Benny-Gil/the-101-router-skadis-mount/docs/images/bracket-dark.png

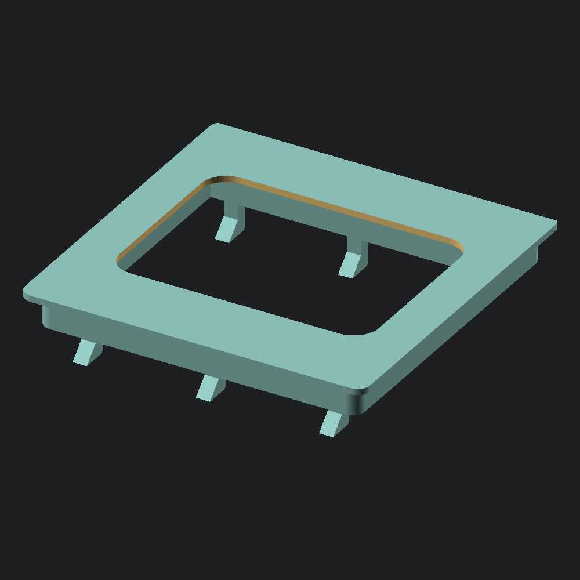
docs/images/bracket-dark.png
