Benny-Gil/the-101-router-skadis-mount/docs/images/hooks-dark.png

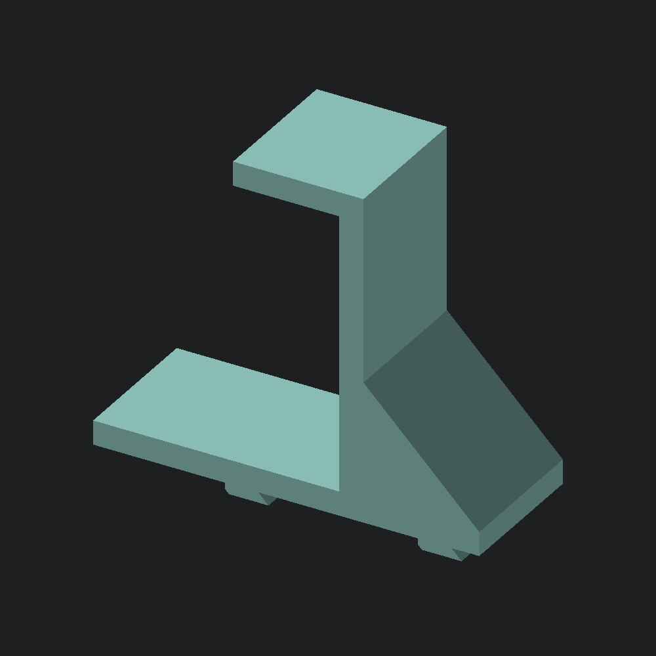
docs/images/hooks-dark.png
