Benny-Gil/the-101-router-skadis-mount/stl/101_skadis_bracket_3mm.stl

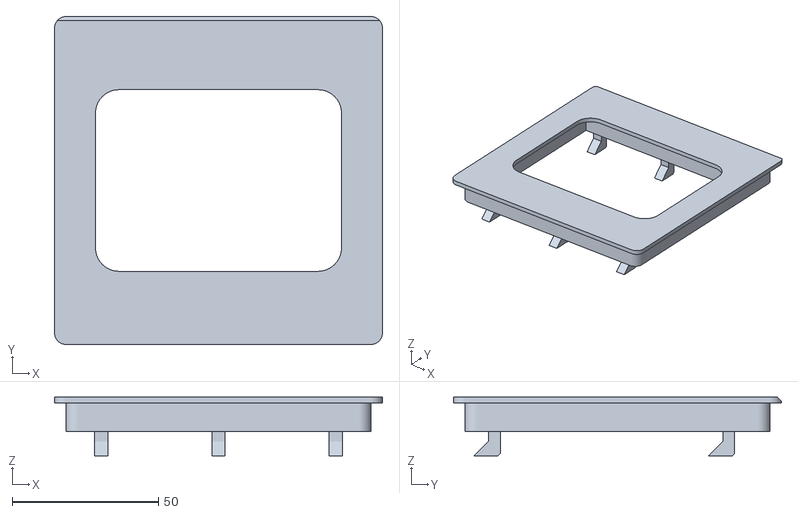
[picture p5: CAD file, 2026-10-25]
stl/101_skadis_bracket_3mm.stl
112.0 x 112.0 x 20.1
