Benny-Gil/the-101-router-skadis-mount/stl/101_skadis_hooks_3mm.stl

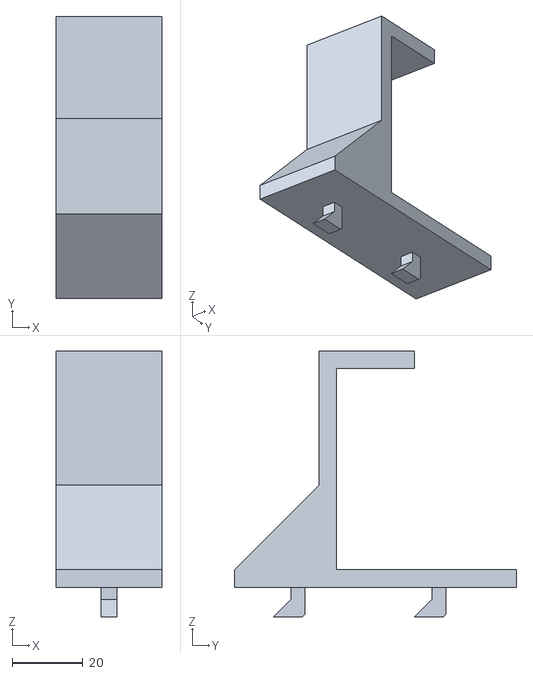
[picture p6: CAD file, 2026-10-25]
stl/101_skadis_hooks_3mm.stl
30.0 x 80.0 x 75.4
