Benny-Gil/the-101-router-skadis-mount/stl/101_skadis_bracket.stl

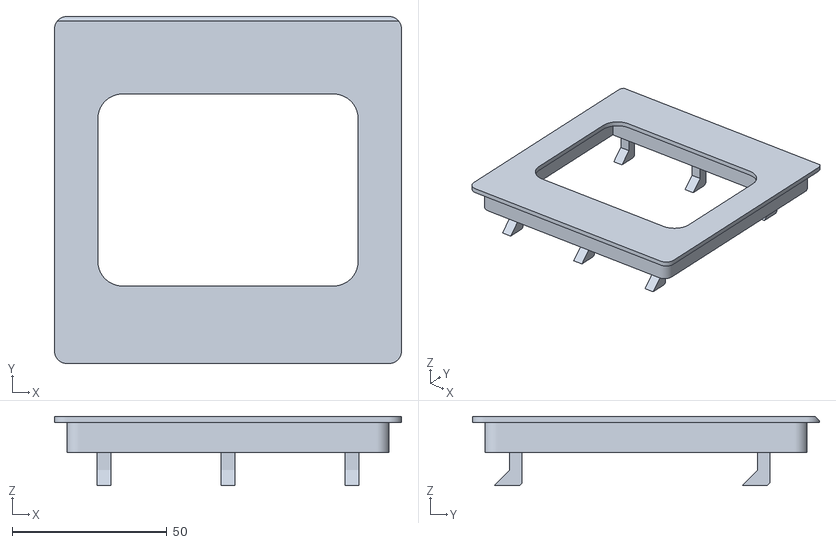
[picture p7: CAD file, 2026-08-27]
stl/101_skadis_bracket.stl
112.0 x 112.0 x 22.3
