Benny-Gil/the-101-router-skadis-mount/stl/101_skadis_hooks.stl

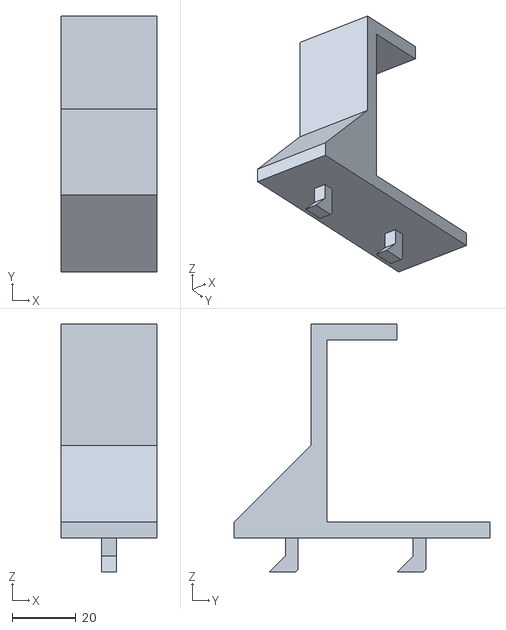
[picture p8: CAD file, 2026-08-27]
stl/101_skadis_hooks.stl
30.0 x 80.0 x 77.6
