Benny-Gil/the-101-router-skadis-mount/(list of files, cad)

Other CAD files:
src/skadis_101_mount.scad
