Benny-Gil/the-101-router-skadis-mount/(commit log)

2026-08-27 SKADIS mount for rain the101: 112x112x2.0 plate, 104mm ring, cradle hooks, tab gauge
    Slide-in captive plate matching the101's retention-tab well, with six SKADIS
    pegs on the back and standoff ribs holding a 6mm air gap off the pegboard.
    Baseline before lightweighting: 74.2 cm3, ~41 g.
    [101_skadis_bracket.stl, 101_skadis_gauge.stl, 101_skadis_hooks.stl, skadis_101_mount.scad]
2026-08-27 Lighten bracket 33%: narrow ribs to 6mm, window out the plate centre
    74.2 -> 49.6 cm3, ~41 -> ~28 g.
    rib_w 10 -> 6: a rib's bending stiffness goes as height cubed and only
    linearly with width, so the 9.7mm standoff was always carrying it. Rib
    second moment drops to 60% against margins that were ~40x, and 6mm still
    leaves 1mm either side of a peg neck.
    New 84x62mm window through the plate's dead centre. The tabs grip the
    perimeter and the load runs perimeter -> ring -> cross ribs -> pegs, all
    outside the cutout. Vents the well as a bonus. Set lighten=false to revert.
    Also raises tongue_t 1.6 -> 2.0 per measurement; standoff absorbs it so
    overall depth stays 22.3mm.
    Worst-case stress after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
    [101_skadis_bracket.stl, skadis_101_mount.scad]
2026-08-27 Track the published build guide alongside the model
    Same page as the artifact at claude.ai/code/artifact/196cbe3a, kept in the
    repo so the docs version with the geometry they describe.
2026-08-27 Drop the commercial bracket listing as a source - it doesn't match this unit
    The Shopee 'the101 wall mounting bracket' listed 121x121x5.7mm and a 75x75
    VESA pattern. None of that matches the unit in hand, so it is removed from
    the .scad header, the README and the build guide.
    Only one number actually derived from it: well_depth, inferred from that
    5.7mm plate thickness. It stays at 5.7 but is now labelled an assumption
    rather than a spec. It only feeds the standoff, and it errs in the safe
    direction - over-estimating just widens the air gap, under-estimating would
    have the ribs foul the router's rim so the plate never seats. Measuring it
    with the gauge's rule is the way to tighten it.
    Ever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
    [skadis_101_mount.scad]
2026-08-27 Drop the tab gauge, restructure into src/stl/docs
    The gauge was a one-off calibration print, not part of the mount. Removed
    its module, parameters and STL, plus every reference in the docs.
    Layout is now src/ for the model, stl/ for exports, docs/ for the guide
    and renders, with a Makefile driving openscad. Both STLs re-export
    byte-identical, so no geometry changed.
    The build guide is now Markdown; its cross-section drawing lives on as a
    standalone docs/images/section.svg.
    Also picked up along the way:
    - tab_gap now backs an assert against tongue_t instead of sitting unused,
    and hook_shelf_d derives from body_t for the same reason
    - README trimmed to the essentials with part renders, an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
    [101_skadis_bracket.stl, 101_skadis_gauge.stl, 101_skadis_hooks.stl, skadis_101_mount.scad]
2026-08-27 Prepare for open source: CC BY-SA 4.0, task-first README
    Add the canonical CC BY-SA 4.0 text as LICENSE, with a copyright header
    on the model and a licence line on the build guide.
    Rewrite the README for someone arriving cold from a link rather than
    someone who already knows the project: lead with what it does, make
    choosing between the two parts the first decision, then download, slice,
    hang. The measurement caveat becomes a "will it fit mine?" check the
    reader can act on instead of a disclaimer. Adds a contributing section
    asking for measurements from other units, since this is built from a
    sample of one.
    Design rationale stays in the build guide, which the README links to.
    [skadis_101_mount.scad]
2026-08-27 Render the part images uniformly, tighten the README
    The two renders were made at different times with different settings:
    Cornfield yellow on cream at 900x720 next to a blue part on white at
    1000x800. Side by side in the README they read as clips from two
    different projects.
    Both are now rendered from one recipe in the Makefile - same 1000x1000
    frame, same orthographic projection, same elevation, one colour scheme
    per theme. Only the azimuth differs per part, so each is seen from the
    side that shows its pegs; the hook was previously shot from behind, with
    its pegs hidden.
    Each part is rendered light and dark, and the docs pick between them with
    <picture> + prefers-color-scheme, so the ima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
2026-08-27 Add the project URL to the model header
    [skadis_101_mount.scad]
2026-10-25 feat(stl): add 3 mm board variants for printed SKADIS panels
    A printed SKADIS panel copies the slot and the grid of an IKEA board, but
    it is 3.0 mm thick instead of 5.2 mm. The peg barb then closes 2.2 mm too
    far out and grips nothing, so the part hangs loose.
    Measurement of the LabRax SKADIS rack panels, 1U to 10U, gives a 3.000 mm
    plate with 5.00 x 15.00 mm slots. The grid is staggered: a row holds a
    slot every 20 mm, and the next row sits 10 mm up and 10 mm across. Every
    one of the 170 slots on the 5U panel has a neighbour 40 mm away on both
    axes, so the six pegs land on real slots and only board_t must change.
    Add stl/101_skadis_bracket_3mm.stl and stl/101_skadis_hooks_3mm.stl, and
    a M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
    [101_skadis_bracket_3mm.stl, 101_skadis_hooks_3mm.stl]
2026-10-25 feat(wedge): add a peg lock that stops the bracket lifting off
    A hung peg rests its neck on the slot's bottom edge, so it fills 4 mm of
    the 15 mm slot. The 11 mm above it is lift travel: raise the bracket by
    that much and the barb clears the slot. The router is removed by lifting
    it off the plate, so the bracket can come away with it.
    The wedge fills that gap. One wedge stops the lift. A second one,
    diagonally opposite, also stops the bracket twisting on its pegs.
    The wedge enters from behind the panel. The perimeter ring encircles all
    six pegs, so a head on the front face has no route out past the ring for
    a finger. Behind the board the space above the peg is clear, because the
    barb hangs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
    [101_skadis_wedge.stl, 101_skadis_wedge_3mm.stl, lock-demo.scad, skadis_101_mount.scad]
2026-10-25 Revert "feat(wedge): add a peg lock that stops the bracket lifting off"
    This reverts commit e976804cc21018f6dbf98c9c3ae0bae484b3e8da.
    [101_skadis_wedge.stl, 101_skadis_wedge_3mm.stl, lock-demo.scad, skadis_101_mount.scad]
